SalihEfeTosunBayraktar/iot-akilli-izleme-kontrol/KUYRUK.md

# İş kuyruğu

Sırayla yapılır; aynı anda tek madde `yapılıyor` olur. Satırlar silinmez, numaralar kaldığı yerden artar.

| # | Bildirim | Durum ve kanıt |
| --- | --- | --- |
| 1 | Nano'yla ilgili şeyleri silmeden Nano yerine ESP32-WROOM mini kullanmak için plan hazırla ve çalış | yapıldı: merkez RF + ESP-NOW'u birlikte dinliyor (`NodeMonitor::ingest`, `EspNowReceiver`), yeni `firmware/room_node_esp32/`, README bağlantı tablosu. Kanıt: iki firmware de derlendi (merkez %93, düğüm %69). Doğrulanmadı: karta yükleme ve uçtan uca test (kartlar takılınca). |
| 2 | 3D web arayüzüne ESP32 mini bağlantılarını ekle | yapıldı: rehberde "Oda düğümü · ESP32 mini" sekmesi (6 adım), tarayıcıda konsol hatasız, yayın v5. |
| 3 | AWS işini kullanmayacağız; kaynaklar şimdilik dursun | yapıldı: `Cloud::kEnabled = false`, AWS kaynakları silinmedi. Kanıt: derleme. Doğrulanmadı: karta yükleme. 6. madde bu kararı yeniden gündeme getiriyor. |
| 4 | ESP32 mini, merkezdeki gibi ayrı büyük breadboard + güç modülüyle beslenecek; ESP mini ayak sıralaması fotoğraftaki gibi (D1 Mini ESP32, çift sıra), kablo dizilimi 3D'de ve kodda buna göre | yapıldı: 3D'de ESP32 sekmesi büyük breadboard + MB102 (üst 5V, alt 3.3V) ve D1 Mini'nin gerçek 40 pinlik dizilimiyle yeniden çizildi (7 adım); güç modülü kodu merkezle ortak fonksiyona alındı (merkez sahnesi kontrol edildi). README bağlantı tablosu ve düğüm config yorumları güncellendi; pin numaraları değişmedi. Kanıt: tarayıcıda iki sahne yüklendi, yayın v6. Doğrulanmadı: gerçek kurulum. |
| 5 | Mimari rehberini portal, düzeltmeler ve ESP-NOW düğümüyle güncelle, PDF'i yeniden üret | 9. maddeyle birleştirildi: mimari rehberi ayrı güncellenmeyecek, teknik rapor bu içeriği kapsayacak |
| 6 | İster: internet üzerinden erişilen dashboard + en az bir kontrol/komut, etkisi gösterilecek | yapıldı: PC sunucusuna komut kuyruğu (POST /api/command, beyaz liste, 60 sn zaman aşımı, Basic Auth giriş), merkez komutu telemetri cevabından alıp sonucunu sonraki gönderimde bildiriyor (2 sn aralık), panelde 'Uzaktan kontrol' bölümü ve komut durum listesi, `start.ps1` (sunucu + Cloudflare Tunnel), README. Kanıt: 13/13 test (komut gidiş-dönüş, bilinmeyen komut 400, zaman aşımı, girişsiz 401); gerçek tünelde herkese açık adres şifresiz 401, şifreyle 200; merkez derlendi (%94). Doğrulanmadı: kartla uçtan uca komut (kartlar takılınca) |
| 7 | İster: kaynak kod GitHub'da, şifre ve anahtarlar açık depoda olmayacak | yapılıyor |
| 8 | İster: README'de açıklama, kurulum/çalıştırma, bağımlılıklar, yapılandırma örnekleri, bileşenler, test yöntemi | yapıldı: bağımlılıklar (kart paketleri, kütüphane sürümleri, Python), yapılandırma örnekleri (`secrets.example.h`, `config.example.json`), test yöntemi, proje yapısı eklendi. Eksik kalan: internet dashboard'unun kullanımı (6. maddeye bağlı) |
| 9 | İster: teknik proje raporu (amaç, gereksinimler, mimari/blok diyagram, donanım-yazılım-iletişim, dashboard tasarımı, uygulama süreci, test senaryoları ve sonuçları, sorunlar, sınırlılıklar, sonuç, kaynakça; gerçek çıktılarla) | açık: 6 ve 10'dan sonra |
| 10 | İster: test senaryoları ve sonuçları (veri akışı, dashboard bağlantısı, komut etkisi, bağlantı kesintisi, hatalı veri/komut) | yapıldı: `docs/test-senaryolari.md` (3 otomatik + 17 donanım senaryosu, tarihli sonuçlarla); geçici klasördeki doğrulama betikleri `tests/` altına kalıcı unittest olarak taşındı. Kanıt: `python -m unittest discover -s tests` 9/9 geçti. Doğrulanmadı: 'Bekliyor' işaretli donanım senaryoları (kart kurulumu ve 6. madde) |
| 11 | İster: 15-20 dk video (amaç, mimari, bileşenler, dashboard, internetten veri ve kontrol, kod yapısı, testler, canlı kayıt) | açık: çekim senaryosu ve sahne listesi hazırlanacak, kaydı kullanıcı yapar |
| 12 | İster: değerlendirmede çalışır sistem gösterimi | açık: demo kontrol listesi |
| 13 | Breadboard'da güç yolları + - + - sırasında; rehber alt tarafı - + çiziyor, düzelt | yapıldı: tüm sahnelerde ray sırası yukarıdan aşağı + − + − (alt çiftte iç sıra +, dış sıra −), çizgi renkleri ve uç etiketleri, MB102 üzerindeki +/− işaretleri buna göre. Bağlantılar ray adına göre çizildiği için kablolar kendiliğinden doğru sıraya geçti. Kanıt: tarayıcıda yüklendi, yayın v7. |
